richardstefun/suzvuk/README.md

# SUZVUK opensource repo

This repo contains all of my opensource synth projects
