richardstefun/suzvuk/prvosienka/eagle/prvosienka.brd

## EAGLE design prvosienka/eagle/prvosienka.brd (2020-02-13)

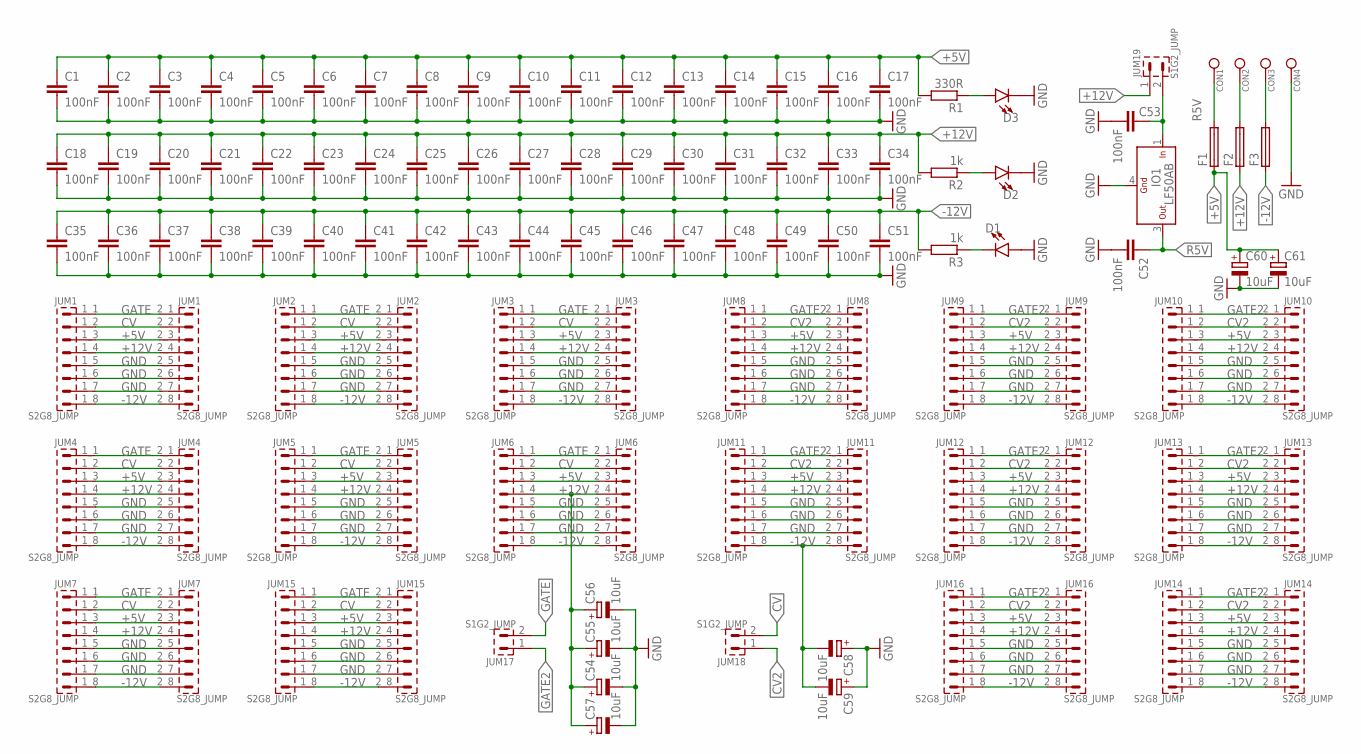
[picture p4: schematic prvosienka.sch]

Parts:
C1, C2, C3, C4, C5, C6, C7, C8, C9, C10, C11, C12, C13, C14, C15, C16, C17, C18, C19, C20, C21, C22, C23, C24, C25, C26, C27, C28, C29, C30, C31, C32, C33, C34, C35, C36, C37, C38, C39, C40, C41, C42, C43, C44, C45, C46, C47, C48, C49, C50, C51, C52, C53: 100nF; C0603K
C54, C55, C56, C57, C58, C59, C60, C61: 10uF; PANASONIC_B
CON1, CON2, CON3, CON4: WAGO256
D1, D2, D3: LED0603; LED-0603
F1, F2, F3: TE5
IO1: LF50AB; DPAK
JUM1, JUM2, JUM3, JUM4, JUM5, JUM6, JUM7, JUM8, JUM9, JUM10, JUM11, JUM12, JUM13, JUM14, JUM15, JUM16: S2G8_JUMP; S2G8_JUM
JUM17, JUM18, JUM19: S1G2_JUMP; S1G2_JUM
R1: 330R; R0603
R2, R3: 1k; R0603

Connections:
+5V: C1.1, C2.1, C3.1, C4.1, C5.1, C6.1, C7.1, C8.1, C9.1, C10.1, C11.1, C12.1, C13.1, C14.1, C15.1, C16.1, C17.1, C60.+, C61.+, F1.1, JUM1.1_3 (3), JUM1.2_3 (3), JUM2.1_3 (3), JUM2.2_3 (3), JUM3.1_3 (3), JUM3.2_3 (3), JUM4.1_3 (3), JUM4.2_3 (3), JUM5.1_3 (3), JUM5.2_3 (3), JUM6.1_3 (3), JUM6.2_3 (3), JUM7.1_3 (3), JUM7.2_3 (3), JUM8.1_3 (3), JUM8.2_3 (3), JUM9.1_3 (3), JUM9.2_3 (3), JUM10.1_3 (3), JUM10.2_3 (3), JUM11.1_3 (3), JUM11.2_3 (3), JUM12.1_3 (3), JUM12.2_3 (3), JUM13.1_3 (3), JUM13.2_3 (3), JUM14.1_3 (3), JUM14.2_3 (3), JUM15.1_3 (3), JUM15.2_3 (3), JUM16.1_3 (3), JUM16.2_3 (3), R1.2
+12V: C18.1, C19.1, C20.1, C21.1, C22.1, C23.1, C24.1, C25.1, C26.1, C27.1, C28.1, C29.1, C30.1, C31.1, C32.1, C33.1, C34.1, C54.+, C55.+, C56.+, C57.+, F2.1, JUM1.1_4 (4), JUM1.2_4 (4), JUM2.1_4 (4), JUM2.2_4 (4), JUM3.1_4 (4), JUM3.2_4 (4), JUM4.1_4 (4), JUM4.2_4 (4), JUM5.1_4 (4), JUM5.2_4 (4), JUM6.1_4 (4), JUM6.2_4 (4), JUM7.1_4 (4), JUM7.2_4 (4), JUM8.1_4 (4), JUM8.2_4 (4), JUM9.1_4 (4), JUM9.2_4 (4), JUM10.1_4 (4), JUM10.2_4 (4), JUM11.1_4 (4), JUM11.2_4 (4), JUM12.1_4 (4), JUM12.2_4 (4), JUM13.1_4 (4), JUM13.2_4 (4), JUM14.1_4 (4), JUM14.2_4 (4), JUM15.1_4 (4), JUM15.2_4 (4), JUM16.1_4 (4), JUM16.2_4 (4), JUM19.1, R2.2
-12V: C35.1, C36.1, C37.1, C38.1, C39.1, C40.1, C41.1, C42.1, C43.1, C44.1, C45.1, C46.1, C47.1, C48.1, C49.1, C50.1, C51.1, C58.-, C59.-, F3.1, JUM1.1_8 (8), JUM1.2_8 (8), JUM2.1_8 (8), JUM2.2_8 (8), JUM3.1_8 (8), JUM3.2_8 (8), JUM4.1_8 (8), JUM4.2_8 (8), JUM5.1_8 (8), JUM5.2_8 (8), JUM6.1_8 (8), JUM6.2_8 (8), JUM7.1_8 (8), JUM7.2_8 (8), JUM8.1_8 (8), JUM8.2_8 (8), JUM9.1_8 (8), JUM9.2_8 (8), JUM10.1_8 (8), JUM10.2_8 (8), JUM11.1_8 (8), JUM11.2_8 (8), JUM12.1_8 (8), JUM12.2_8 (8), JUM13.1_8 (8), JUM13.2_8 (8), JUM14.1_8 (8), JUM14.2_8 (8), JUM15.1_8 (8), JUM15.2_8 (8), JUM16.1_8 (8), JUM16.2_8 (8), R3.2
CV: JUM1.1_2 (2), JUM1.2_2 (2), JUM2.1_2 (2), JUM2.2_2 (2), JUM3.1_2 (2), JUM3.2_2 (2), JUM4.1_2 (2), JUM4.2_2 (2), JUM5.1_2 (2), JUM5.2_2 (2), JUM6.1_2 (2), JUM6.2_2 (2), JUM7.1_2 (2), JUM7.2_2 (2), JUM15.1_2 (2), JUM15.2_2 (2), JUM18.2
CV2: JUM8.1_2 (2), JUM8.2_2 (2), JUM9.1_2 (2), JUM9.2_2 (2), JUM10.1_2 (2), JUM10.2_2 (2), JUM11.1_2 (2), JUM11.2_2 (2), JUM12.1_2 (2), JUM12.2_2 (2), JUM13.1_2 (2), JUM13.2_2 (2), JUM14.1_2 (2), JUM14.2_2 (2), JUM16.1_2 (2), JUM16.2_2 (2), JUM18.1
GATE: JUM1.1_1 (1), JUM1.2_1 (1), JUM2.1_1 (1), JUM2.2_1 (1), JUM3.1_1 (1), JUM3.2_1 (1), JUM4.1_1 (1), JUM4.2_1 (1), JUM5.1_1 (1), JUM5.2_1 (1), JUM6.1_1 (1), JUM6.2_1 (1), JUM7.1_1 (1), JUM7.2_1 (1), JUM15.1_1 (1), JUM15.2_1 (1), JUM17.2
GATE2: JUM8.1_1 (1), JUM8.2_1 (1), JUM9.1_1 (1), JUM9.2_1 (1), JUM10.1_1 (1), JUM10.2_1 (1), JUM11.1_1 (1), JUM11.2_1 (1), JUM12.1_1 (1), JUM12.2_1 (1), JUM13.1_1 (1), JUM13.2_1 (1), JUM14.1_1 (1), JUM14.2_1 (1), JUM16.1_1 (1), JUM16.2_1 (1), JUM17.1
GND: C1.2, C2.2, C3.2, C4.2, C5.2, C6.2, C7.2, C8.2, C9.2, C10.2, C11.2, C12.2, C13.2, C14.2, C15.2, C16.2, C17.2, C18.2, C19.2, C20.2, C21.2, C22.2, C23.2, C24.2, C25.2, C26.2, C27.2, C28.2, C29.2, C30.2, C31.2, C32.2, C33.2, C34.2, C35.2, C36.2, C37.2, C38.2, C39.2, C40.2, C41.2, C42.2, C43.2, C44.2, C45.2, C46.2, C47.2, C48.2, C49.2, C50.2, C51.2, C52.2, C53.2, C54.-, C55.-, C56.-, C57.-, C58.+, C59.+, C60.-, C61.-, CON4.1, D1.A, D2.C, D3.C, IO1.4 (GND), JUM1.1_5 (5), JUM1.1_6 (6), JUM1.1_7 (7), JUM1.2_5 (5), JUM1.2_6 (6), JUM1.2_7 (7), JUM2.1_5 (5), JUM2.1_6 (6), JUM2.1_7 (7), JUM2.2_5 (5), JUM2.2_6 (6), JUM2.2_7 (7), JUM3.1_5 (5), JUM3.1_6 (6), JUM3.1_7 (7), JUM3.2_5 (5), JUM3.2_6 (6), JUM3.2_7 (7), JUM4.1_5 (5), JUM4.1_6 (6), JUM4.1_7 (7), JUM4.2_5 (5), JUM4.2_6 (6), JUM4.2_7 (7), JUM5.1_5 (5), JUM5.1_6 (6), JUM5.1_7 (7), JUM5.2_5 (5), JUM5.2_6 (6), JUM5.2_7 (7), JUM6.1_5 (5), JUM6.1_6 (6), JUM6.1_7 (7), JUM6.2_5 (5), JUM6.2_6 (6), JUM6.2_7 (7), JUM7.1_5 (5), JUM7.1_6 (6), JUM7.1_7 (7), JUM7.2_5 (5), JUM7.2_6 (6), JUM7.2_7 (7), JUM8.1_5 (5), JUM8.1_6 (6), JUM8.1_7 (7), JUM8.2_5 (5), JUM8.2_6 (6), JUM8.2_7 (7), JUM9.1_5 (5), JUM9.1_6 (6), JUM9.1_7 (7), JUM9.2_5 (5), JUM9.2_6 (6), JUM9.2_7 (7), JUM10.1_5 (5), JUM10.1_6 (6), JUM10.1_7 (7), JUM10.2_5 (5), JUM10.2_6 (6), JUM10.2_7 (7), JUM11.1_5 (5), JUM11.1_6 (6), JUM11.1_7 (7), JUM11.2_5 (5), JUM11.2_6 (6), JUM11.2_7 (7), JUM12.1_5 (5), JUM12.1_6 (6), JUM12.1_7 (7), JUM12.2_5 (5), JUM12.2_6 (6), JUM12.2_7 (7), JUM13.1_5 (5), JUM13.1_6 (6), JUM13.1_7 (7), JUM13.2_5 (5), JUM13.2_6 (6), JUM13.2_7 (7), JUM14.1_5 (5), JUM14.1_6 (6), JUM14.1_7 (7), JUM14.2_5 (5), JUM14.2_6 (6), JUM14.2_7 (7), JUM15.1_5 (5), JUM15.1_6 (6), JUM15.1_7 (7), JUM15.2_5 (5), JUM15.2_6 (6), JUM15.2_7 (7), JUM16.1_5 (5), JUM16.1_6 (6), JUM16.1_7 (7), JUM16.2_5 (5), JUM16.2_6 (6), JUM16.2_7 (7)
unnamed: D3.A, R1.1
unnamed: D2.A, R2.1
unnamed: D1.C, R3.1
unnamed: CON3.1, F3.2
unnamed: CON2.1, F2.2
unnamed: C53.1, IO1.1 (IN), JUM19.2
R5V: C52.1, CON1.1, F1.2, IO1.3 (OUT)

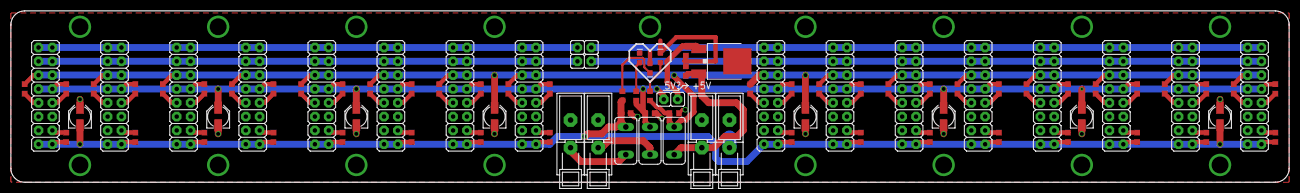
[picture p5: board prvosienka.brd from above]

Board: 2 copper layers, 234.9 x 31.5 mm, 94 parts (0 on the bottom side), 15 nets.
