richardstefun/suzvuk/(commit log)

2020-02-13 eagle files and render
    [prvosienka.brd, prvosienka.sch]
2020-02-14 led detail
2020-02-14 gerber files
    [untitled.GBL, untitled.GBO, untitled.GBP, untitled.GBS, untitled.GTL, untitled.GTO, untitled.GTP, untitled.GTS]
2020-02-14 changed led detail
