richardstefun/suzvuk/(notices)

Notices in the files:
parts and their libraries:
Copyright (C) PaJa 2011-2014
Copyright (C) PaJa 2001-2014
SparkFun-LED: Licensing: Creative Commons ShareAlike 4.0 International - https://creativecommons.org/licenses/by-sa/4.0
